DynamoBen/WIFItally/Hardware/Pictures/front.png

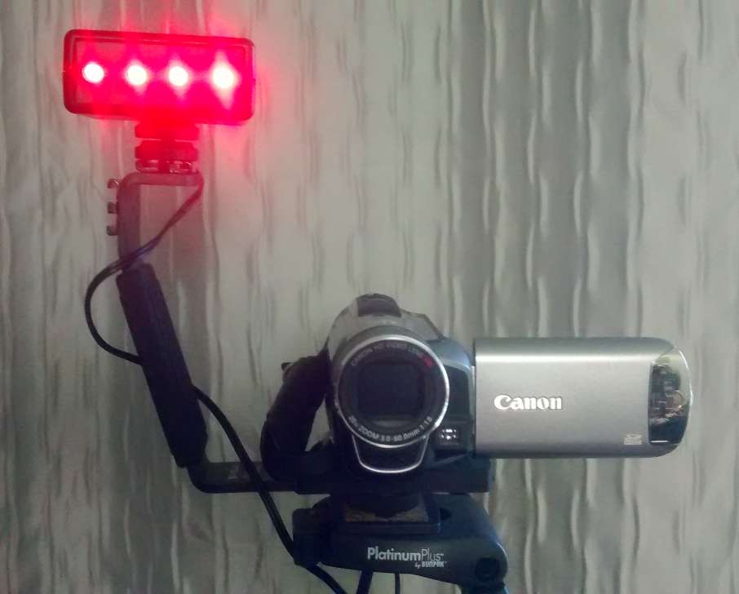
Hardware/Pictures/front.png
