DynamoBen/WIFItally/Hardware/Pictures/operatorgrn.png

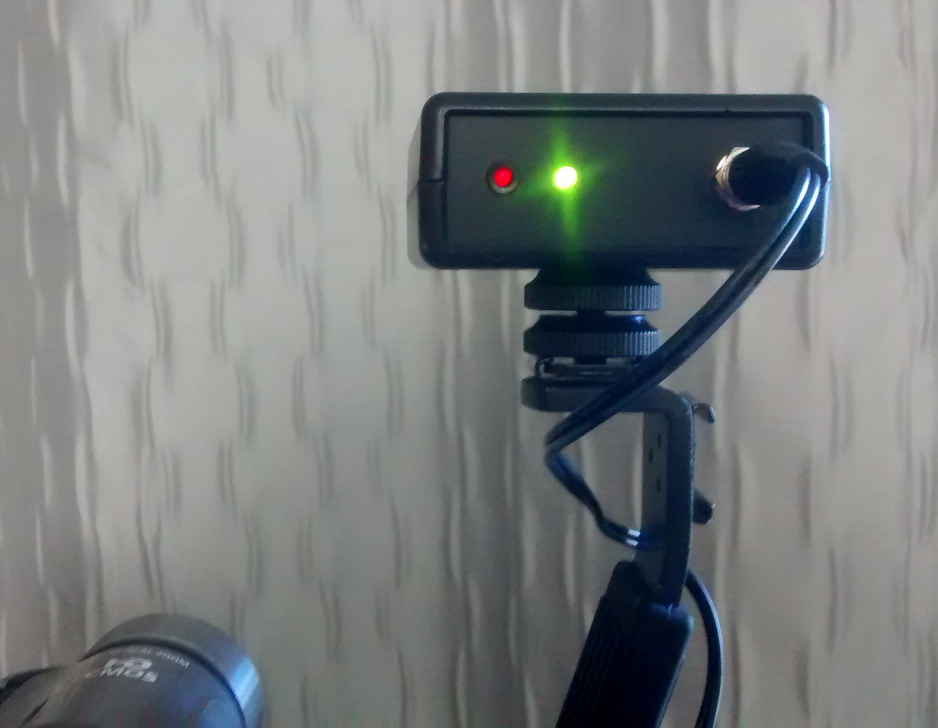
Hardware/Pictures/operatorgrn.png
