DynamoBen/WIFItally/README.md

# WIFI Tally Light 

## Description
An inexpensive WIFI tally light system based on the ESP8266 and works with [Wirecast]( https://www.telestream.net/wirecast/overview.htm), [vMix](https://www.vmix.com/), [Blackmagic ATEM](https://www.blackmagicdesign.com). 

This design allows for up to 256 tally lights (1-256). Each light has independently dimmable Tally and Operator light(s) and the operator sees both live and preview indicators. Each tally light is configurable via a webpage, allowing the user to change WIFI settings, the intensity of each LED, and upgrade firmware.

### Features
* Tally and Operator LEDs
* Live and Preview Indication
* Dimmable LEDs
* WIFI connectivity (802.11 b / g / n)
* Webpage configuration
* Up to 256 Individually addressable lights
* Upgradable firmware
* Wirecast, vMix, Blackmagic ATEM ([additional hardware required]( https://github.com/henne-/wifitally))

## Learn More
[Check out the wiki for more information](https://github.com/DynamoBen/WIFItally/wiki)
