DynamoBen/WIFItally/Hardware/Pictures/inside.png

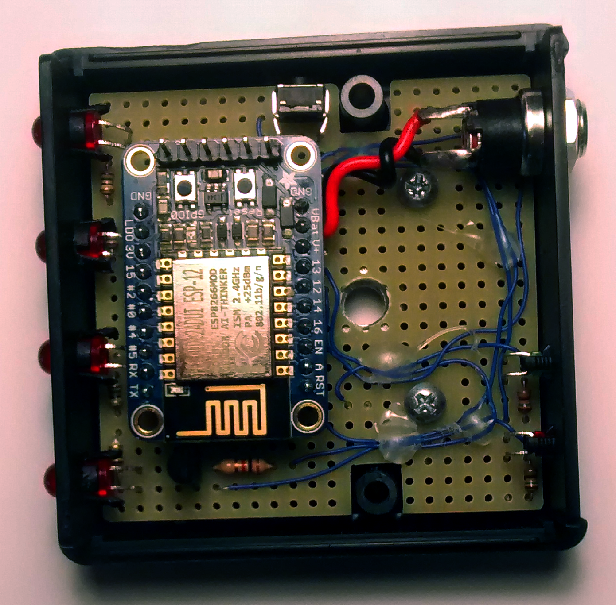
Hardware/Pictures/inside.png
