DynamoBen/WIFItally/Hardware/Pictures/operatorred.png

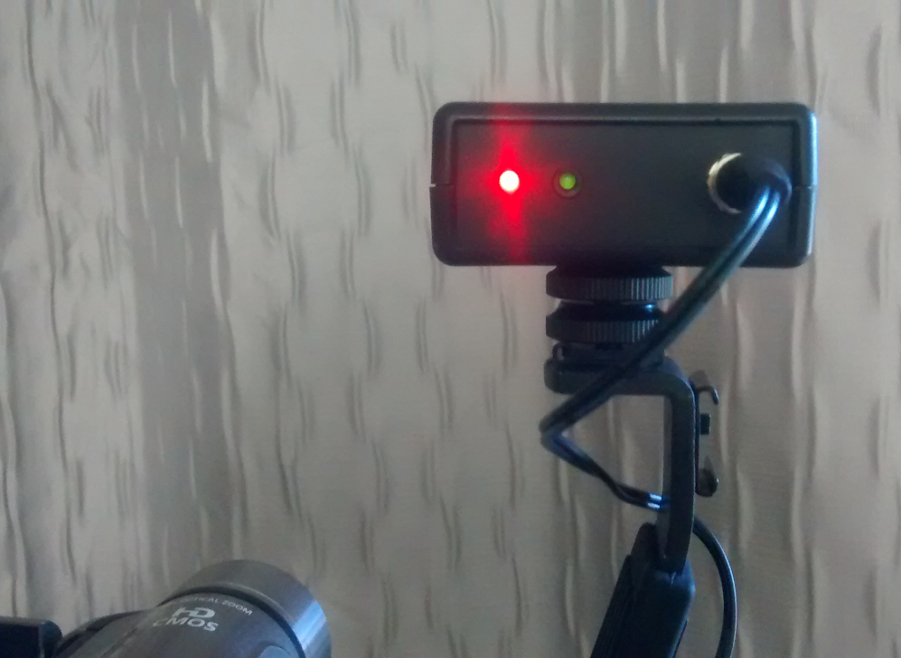
Hardware/Pictures/operatorred.png
