DynamoBen/WIFItally/Hardware/Pictures/side.png

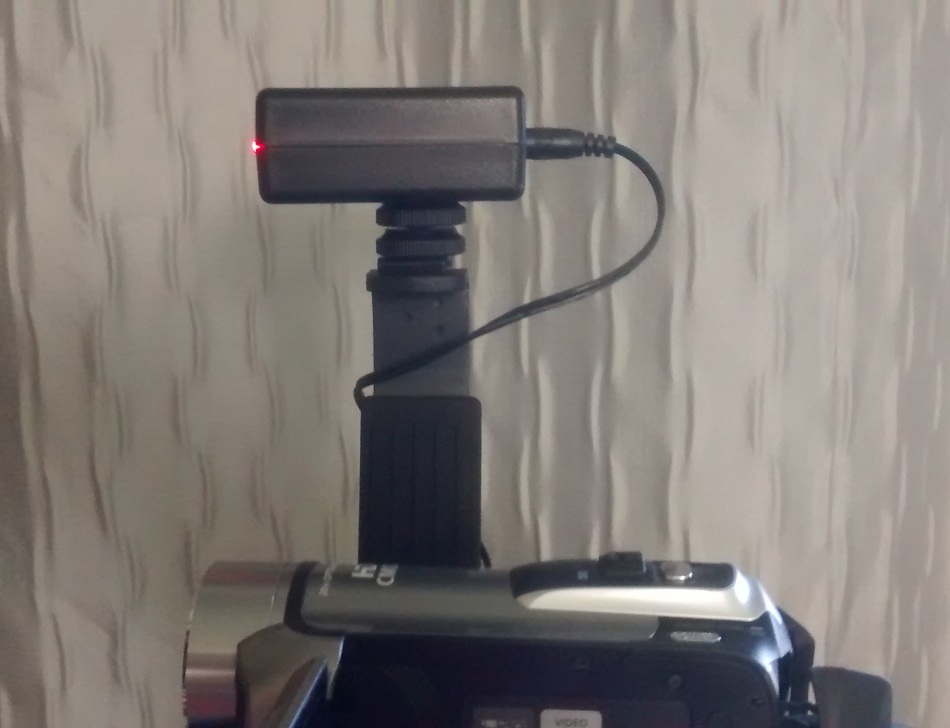
Hardware/Pictures/side.png
