DynamoBen/WIFItally/Hardware/BOM.pdf

Qty | RefDes Description
1 | D4 | LED GREEN DIFF 3MM ROUND
1 | D7 | LED RED DIFF 3MM ROUND
4 | D8-10 | LED RED DIFF 5MM ROUND
1 | J1 | CONN PWR JACK 2.1X5.5MM
1 | Q1 | 2N3904 TRANS NPN 40V 0.2A TO-92
1 | R5 | RES 1K OHM 1/4W 5% CF AXIAL

### 4 R10-13 RES 150 OHM 1/8W 5% CF AXIAL

1 | SW3 | SWITCH TACTILE SPST-NO, Through Hole-Right Angle

### 1 Adafruit ESP8266 HUZZAH BREAKOUT BOARD (p/n 2471) 1 AC/DC WALL MOUNT ADAPTER 5V 8W
