DynamoBen/WIFItally/Hardware/Case_BOM.pdf

Qty Description

### 1 Hammond 1593KBK BOX ABS BLACK 1 Hammond 1593KPCB COPP CLAD DRILLED BREADBRD

1 1/4" Tripod Mount Screw to Hot Shoe Adapter
1 1/4" Jam Nut

### 2 LED HOLDER BLACK NYLON - T1 (3MM) 4 LED HOLDER BLACK NYLON - 5MM
