DynamoBen/WIFItally/Hardware/WIFI_Tally_Schematic.pdf

## Adafruit HUZZAH ESP8266 Breakout

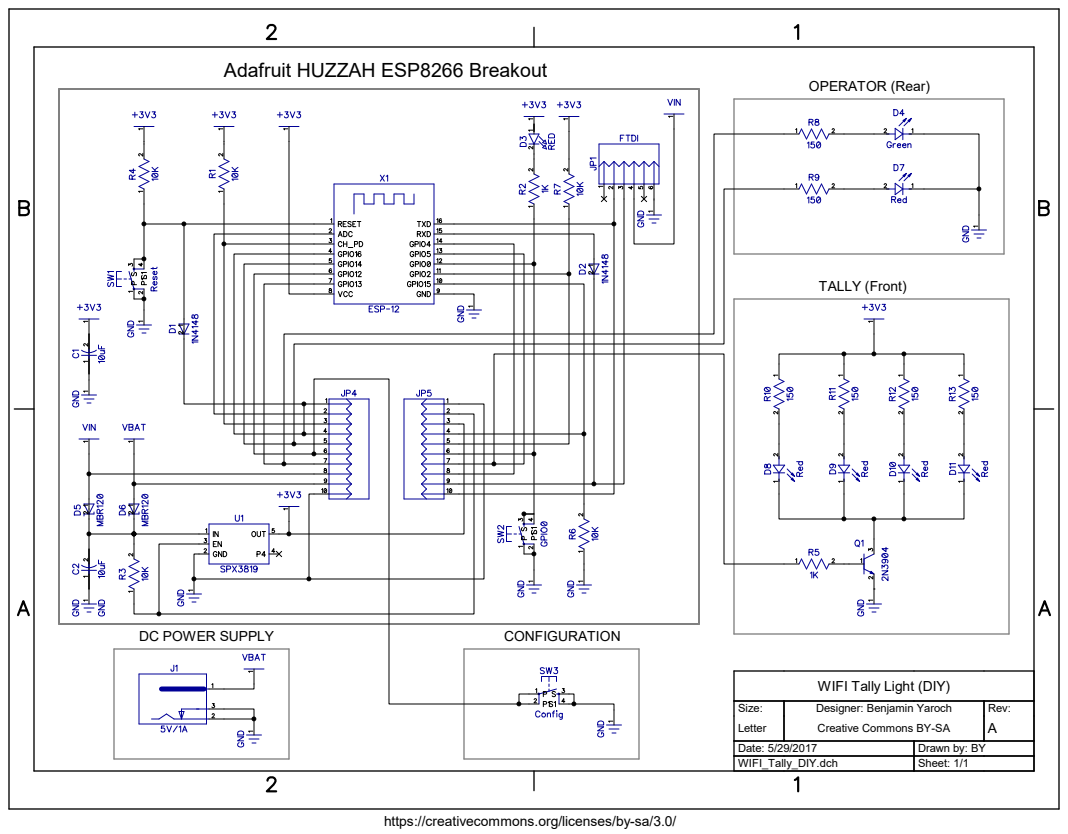
[picture p6: page 1]
OPERATOR (Rear); TALLY (Front); DC POWER SUPPLY; CONFIGURATION

WIFI Tally Light (DIY)

Size: Letter | Designer: Benjamin Yaroch Creative Commons BY-SA | Rev: A

Date: 5/29/2017 | Drawn by: BY
WIFI_Tally_DIY.dch | Sheet: 1/1

https://creativecommons.org/licenses/by-sa/3.0/
