DynamoBen/WIFItally/(threads)

Thread 3 (2018-09-04):

Keine Multicast Verbindung zwischen Arduino und ESP8266 möglich

nobodykmd, 2018-09-04:
Hey ich habe Schwierigkeiten eine Verbindung zwischen Arduino und dem ESP zu realisieren trotz aller Modifikationen welche via Anleitung zu tätigen sind.

Haben Sie eine Idee wie man aktuell eine Verbindung realisieren kann.

Ich verwende ein Wemos D1 und ein Arduino Mega mit einem EthernetShield W5100.

DynamoBen, 2018-09-04:
Sorry dieses projekt nicht verwenden und Arduino ist es nur um das ESP konzipiert. Ich kann Ihnen mit dem Arduino Mega oder W5100 nicht helfen.

Closed 2018-09-04.

Thread 5 (2019-02-26):

How to make this work with Blackmagic ATEM?

DynamoBen, 2019-02-26:
This project has been designed and tested with both vMix and Wirecast. However the documentation mentions that this could also be used with an ATEM (which hasn't been tested). A link is provided to another [project ](https://github.com/henne-/wifitally) which has some [Arduino code](https://github.com/henne-/wifitally/tree/master/software/transmitter) that acts as a gateway between an ATEM and a tally light system. That transmitter project could be used with these tally lights after some minor code changes, specifically the network packet transmission.

If you successfully connect this project with an ATEM please post a follow-up here.

DynamoBen, 2025-09-10:
> hi, I modified the wirecast bridge by adding failback to Atem, tested and it works, I attach the py code:
>
> [blackmagicTallyBridge.py](https://github.com/user-attachments/files/21845383/blackmagicTallyBridge.py)

Any chance you could trim the code so this is a standalone ATEM bridge vs including Wirecast? I would but I have no way of testing the code.

Samuele-Wired, 2025-09-10:
yes, I create the script only for ATEM

Samuele-Wired, 2025-09-15:
[bmaTallyBridge.py](https://github.com/user-attachments/files/22330811/bmaTallyBridge.py)

Samuele-Wired, 2025-09-15:
update for you

Thread 6 (2019-02-26):

Will this work with a Node MCU?

DynamoBen, 2019-02-26:
This project will likely work with a Node MCU (has not been tested). The Huzzah was used because it didn't require any additional components beyond the items needed to build the tally light, it is FCC certified, and it was compact.

In this projects schematic I've included the schematic for the Huzzah, compare it against the Node MCU schematic to determine what might need to be added or changed to make this project function as designed.

Please post success stories in this thread with modification details.

DynamoBen, 2020-07-28:
A vMix user posted the changes that are required to use Node MCU: [(https://forums.vmix.com/posts/m76495-WIFI-Tally-lights---Open-Source#post76495)]

Closed 2020-07-28.

Thread 7 (2019-03-12):

Do not do libraries

alirezaershadmanesh, 2019-03-12:
Hello
I was compiling the program. But these libraries are not: #include <StreamString.h> and #include <FS.h> and #include <WiFiUdp.h>
Where can I find them?

DynamoBen, 2019-03-12:
It appears that you don't have the ESP8266 board libraries installed correctly. [These instructions](https://learn.adafruit.com/adafruit-huzzah-esp8266-breakout/using-arduino-ide) may help.

alirezaershadmanesh, 2019-03-12:
I did the same, but without the module. Of course, I have to compile the code without the module, but it does not do this.

alirezaershadmanesh, 2019-03-27:
Hi. I copied the function fs.h. but it's still not in red. The program is
compiling, but ssdid does not appear .Please helpe me

On Tue, Mar 12, 2019 at 6:41 PM Benjamin Yaroch <notifications@github.com>
wrote:

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

DynamoBen, 2019-03-27:
I can't tell from your description what the root cause of your problem is. FS.h is included at the project level and doesn't need to be copied anywhere.

What you're experiencing appears to be a development environment setup issue. If your IDE is setup correctly and you have all the dependencies installed then the project will compile and run correctly.

alirezaershadmanesh, 2019-03-27:
I use Arduino 1.8.6. I went through the steps, except for this line:
To upload the static files via the Arduino IDE you will need this tool:
https://github.com/esp8266/arduino-esp8266fs-plugin
Do I have to go through this line?

On Wed, Mar 27, 2019 at 9:08 PM Benjamin Yaroch <notifications@github.com>
wrote:

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

DynamoBen, 2019-03-27:
> I use Arduino 1.8.6. I went through the steps, except for this line: To upload the static files via the Arduino IDE you will need this tool: https://github.com/esp8266/arduino-esp8266fs-plugin Do I have to go through this line?

The project will compile and function without this step, however the configuration webpages will not be themed correctly and look a bit odd.

alirezaershadmanesh, 2019-04-01:
Hi, good time. Maybe a new link will send me the functions and necessary
items. Maybe I downloaded the wrong one because the link links have expired.
As atem.h   fs,h EthernetUdp.h.I just have these problems
Thank you

On Wed, Mar 27, 2019 at 9:40 PM Benjamin Yaroch <notifications@github.com>
wrote:

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

alirezaershadmanesh, 2019-04-24:
Hi, I talked to an expert engineer. She saw all the software. He has
trouble-free functions fs.h. You may check the functions in a new way. And
give it a link?
I need this very much
Please give me all the functions
Thank you

On Tue, Mar 12, 2019 at 6:41 PM Benjamin Yaroch <notifications@github.com>
wrote:

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

DynamoBen, 2019-04-24:
When you program your device ensure that under Tools | Flash Size that the option selected is NOT "no SPIFFS." FS needs SPIFFS to function.

alirezaershadmanesh, 2019-09-25:
Hello i have a private message, can i say it?

On Sat, Sep 21, 2019 at 8:09 AM Benjamin Yaroch <notifications@github.com>
wrote:

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

Closed 2019-09-21.

Thread 11 (2023-06-17):

compile error: 'PWMRANGE' was not declared in this scope

Samuele-Wired, 2023-06-17:
When I try to compile with Ardino, I get an error that the variable has not been declared

Samuele-Wired, 2023-06-18:
resoved: add
#define PWMRANGE 255

Closed 2023-06-18.
