DynamoBen/WIFItally/(commit log)

2017-08-25 Added inside photo
    Photo of inside of prototype
2017-09-01 Added missing R5 resistor
